olihandy/ENMT-ROBOCUP/CAD/T8x4 (P2) lead screw - 2.png

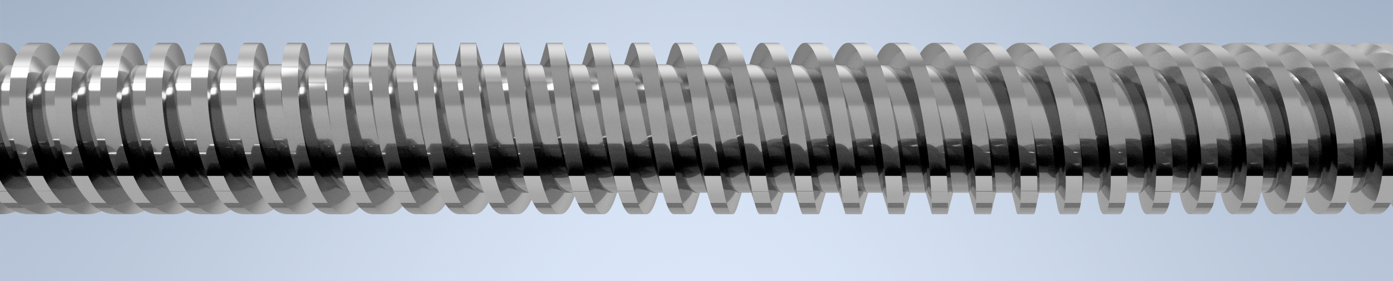
CAD/T8x4 (P2) lead screw - 2.png
