olihandy/ENMT-ROBOCUP/README.md

**TO DO**
1. Do cad
2. Build robot
3. Write report(s)
4. WIN ROBOCUP
