olihandy/ENMT-ROBOCUP/CAD/Robo_Assembly.SLDASM

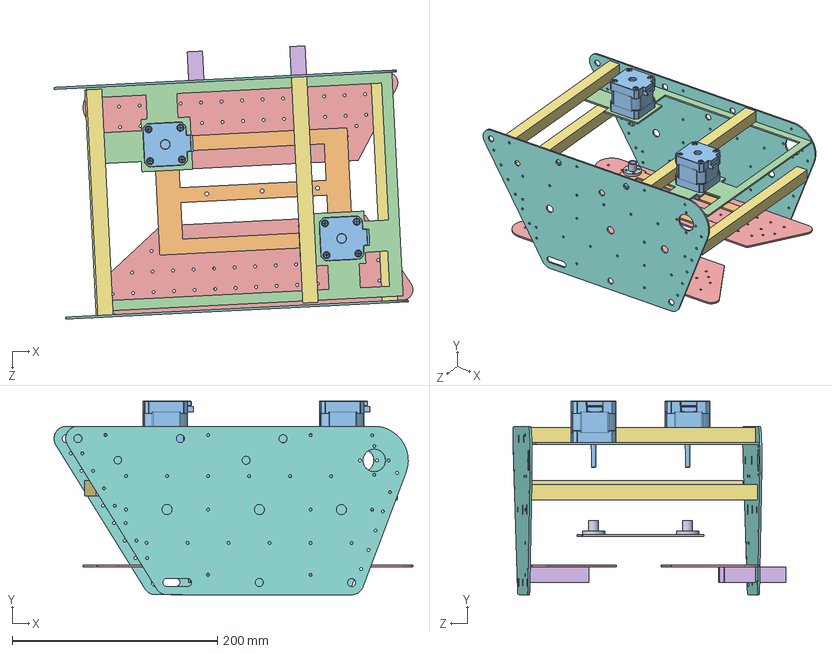
[picture p11: CAD file, 2024-07-29]
CAD/Robo_Assembly.SLDASM
349.6 x 188.7 x 266.1 mm
frame_side x 2
Open_Beam_300mm x 4
Open_Beam_30mm x 4
Frame_lower x 2
Frame_magnet mount
17HS4401 x 2
Frame_Electromagnet
brass piece x 2
