olihandy/ENMT-ROBOCUP/CAD/battery holder.SLDPRT

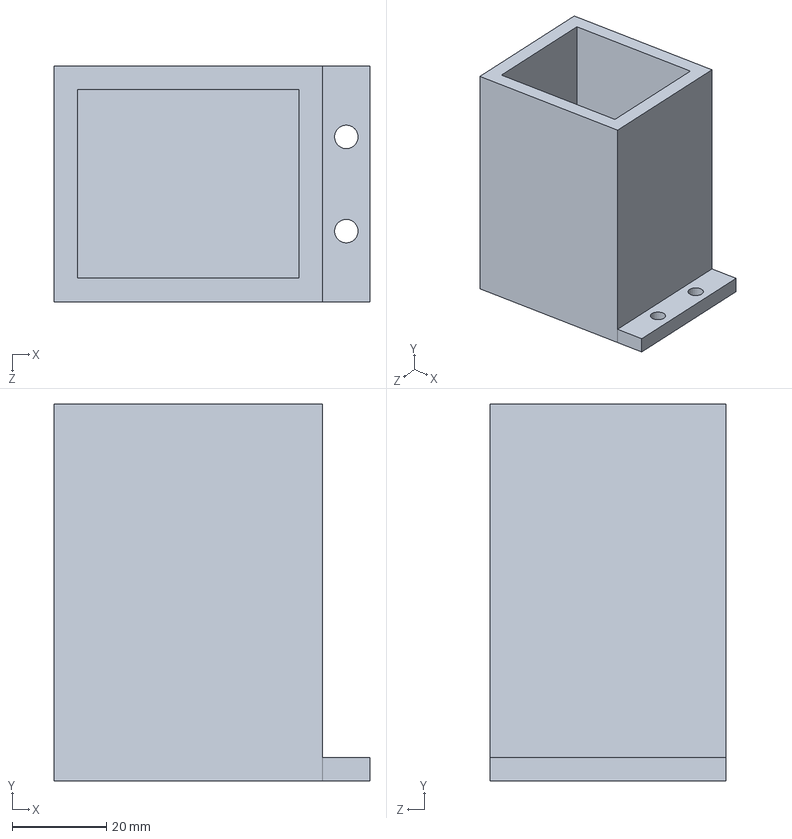
[picture p12: CAD file, 2024-09-09]
CAD/battery holder.SLDPRT
67.0 x 80.0 x 50.0 mm
