olihandy/ENMT-ROBOCUP/CAD/vl53l0x/pin_header.SLDPRT

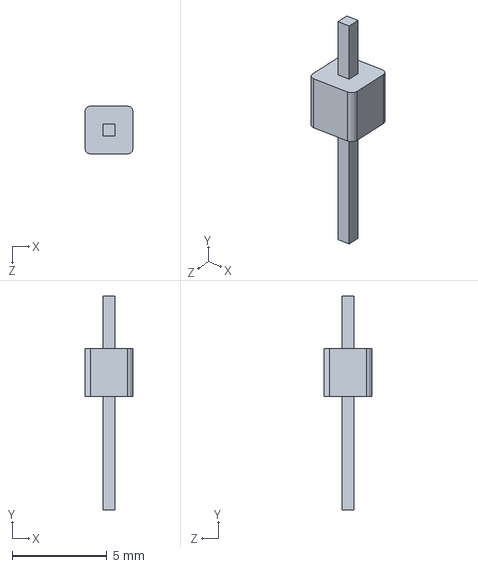
[picture p13: CAD file, 2024-09-09]
CAD/vl53l0x/pin_header.SLDPRT
2.54 x 11.3 x 2.54 mm
