olihandy/ENMT-ROBOCUP/CAD/motor driver.SLDPRT

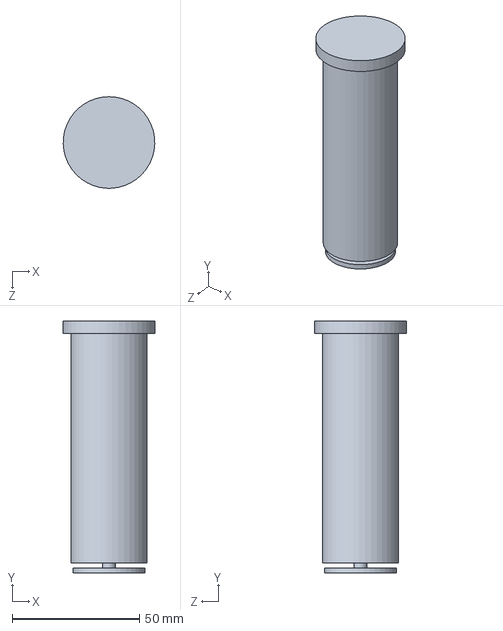
[picture p14: CAD file, 2024-09-09]
CAD/motor driver.SLDPRT
36.0 x 99.0 x 36.0 mm
