olihandy/ENMT-ROBOCUP/CAD/vl53l0x/GY-VL53L1XV2.SLDPRT

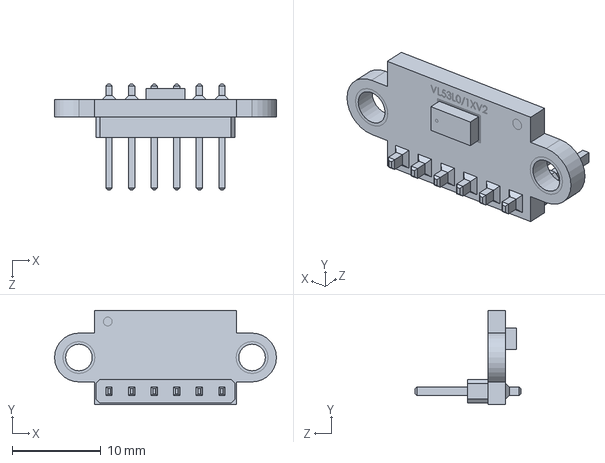
[picture p15: CAD file, 2024-09-09]
CAD/vl53l0x/GY-VL53L1XV2.SLDPRT
25.0 x 10.6 x 11.9 mm
