olihandy/ENMT-ROBOCUP/CAD/frame_side.SLDPRT

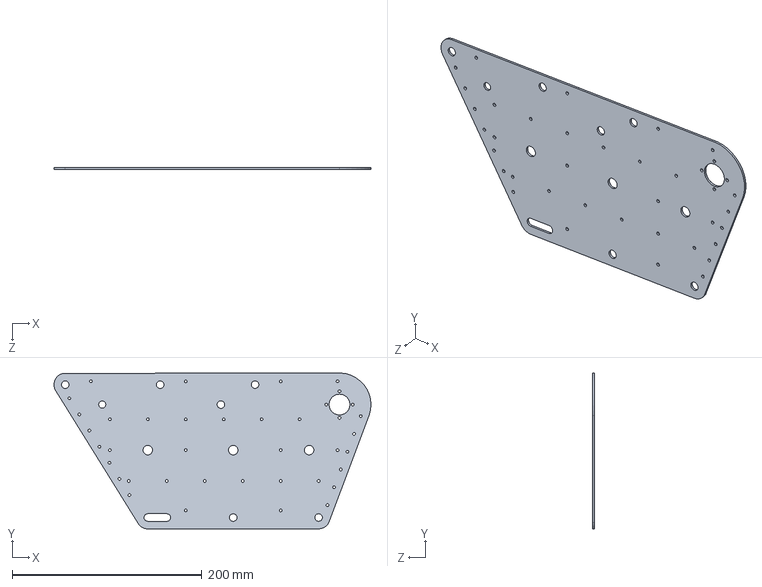
[picture p16: CAD file, 2024-09-09]
CAD/frame_side.SLDPRT
334.0 x 164.2 x 2.00 mm
