olihandy/ENMT-ROBOCUP/CAD/vl53l0x/vl53l0x_PCB.SLDPRT

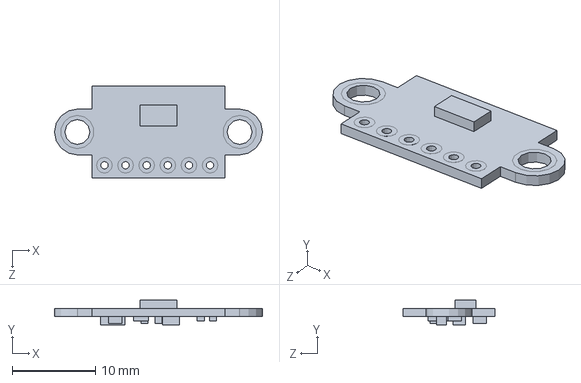
[picture p17: CAD file, 2024-09-09]
CAD/vl53l0x/vl53l0x_PCB.SLDPRT
25.0 x 3.00 x 11.0 mm
