olihandy/ENMT-ROBOCUP/CAD/Frame_Electromagnet.SLDPRT

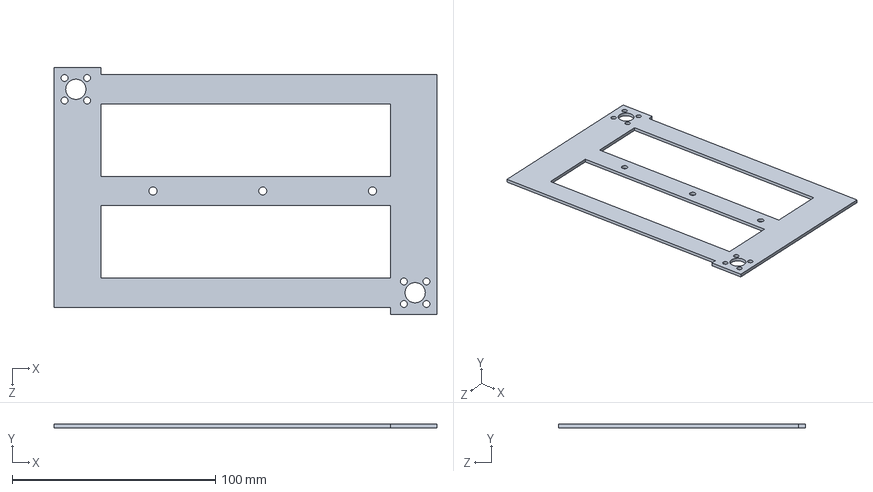
[picture p18: CAD file, 2024-09-09]
CAD/Frame_Electromagnet.SLDPRT
188.5 x 2.00 x 121.6 mm
