olihandy/ENMT-ROBOCUP/CAD/power supply.SLDPRT

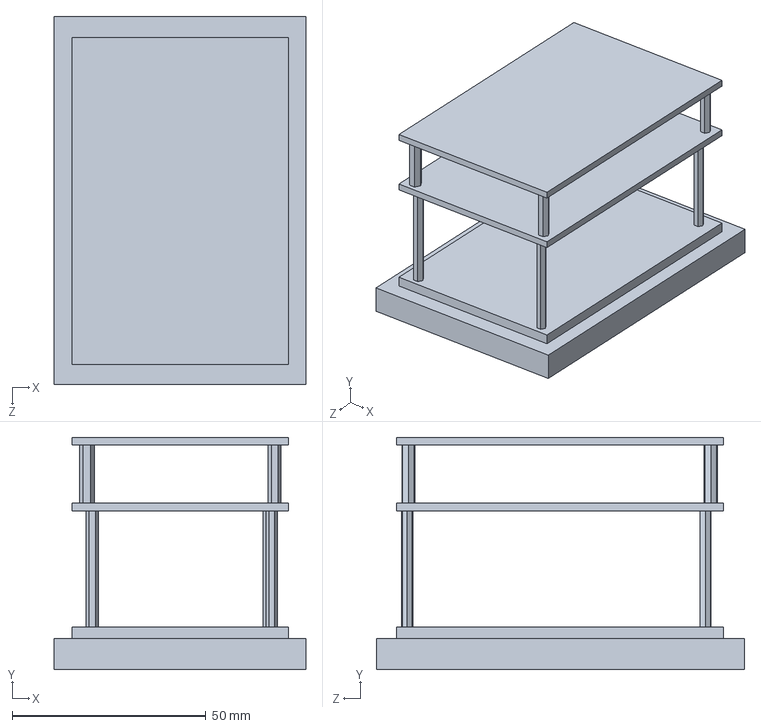
[picture p20: CAD file, 2024-09-09]
CAD/power supply.SLDPRT
65.0 x 60.0 x 95.0 mm
