olihandy/ENMT-ROBOCUP/CAD/vl53l0x/TOF_sensorholder.3MF

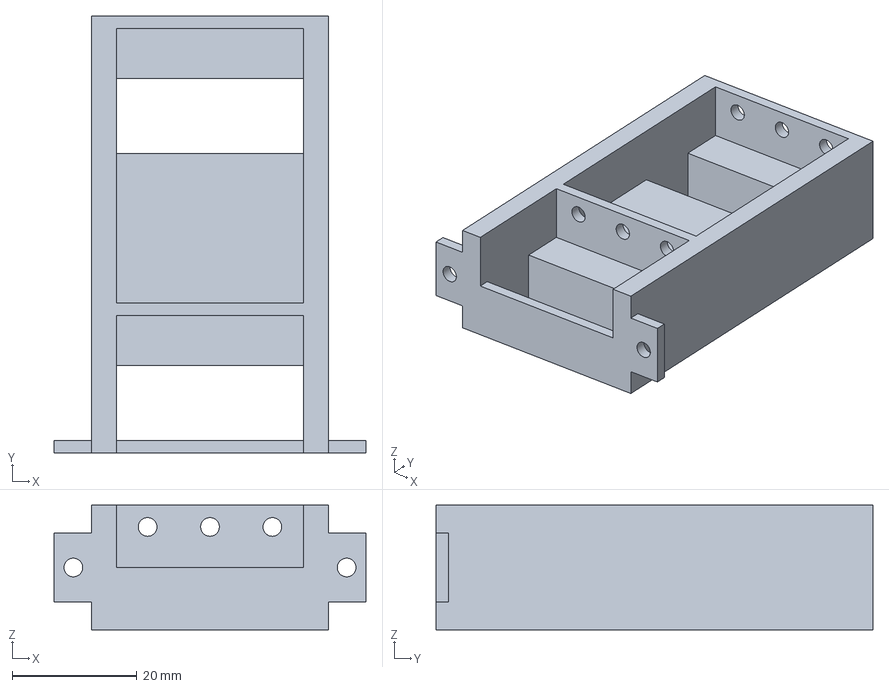
[picture p21: CAD file, 2024-09-09]
CAD/vl53l0x/TOF_sensorholder.3MF
50.0 x 70.0 x 20.0 mm
