olihandy/ENMT-ROBOCUP/CAD/track.SLDPRT

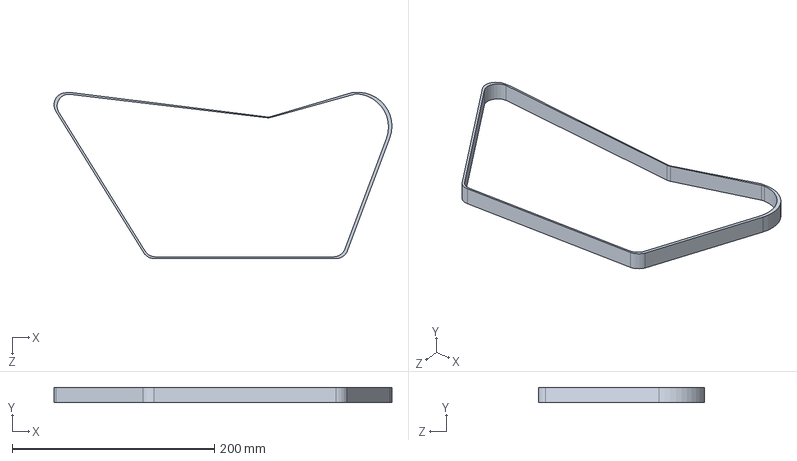
[picture p22: CAD file, 2024-09-09]
CAD/track.SLDPRT
334.0 x 15.0 x 164.2 mm
