olihandy/ENMT-ROBOCUP/CAD/1515 Aluminum Extrusion69420mm.SLDPRT

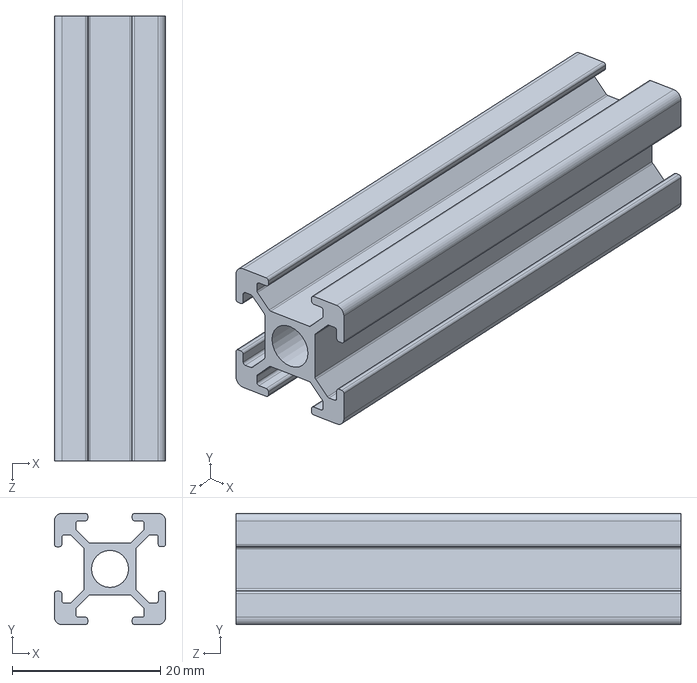
[picture p23: CAD file, 2024-09-09]
CAD/1515 Aluminum Extrusion69420mm.SLDPRT
15.0 x 15.0 x 60.0 mm
