olihandy/ENMT-ROBOCUP/CAD/wheel.SLDPRT

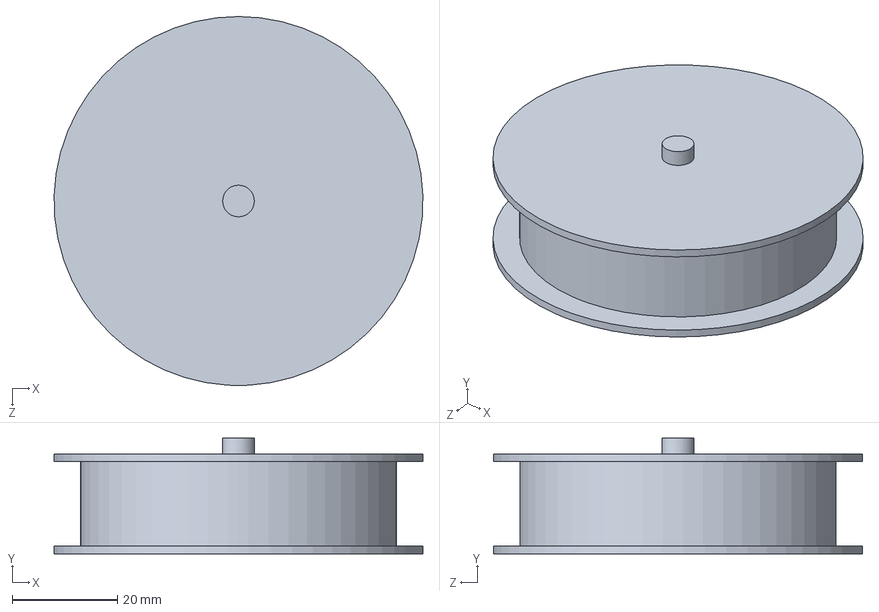
[picture p24: CAD file, 2024-09-09]
CAD/wheel.SLDPRT
70.0 x 22.0 x 70.0 mm
