olihandy/ENMT-ROBOCUP/CAD/Inductive level shift.SLDPRT

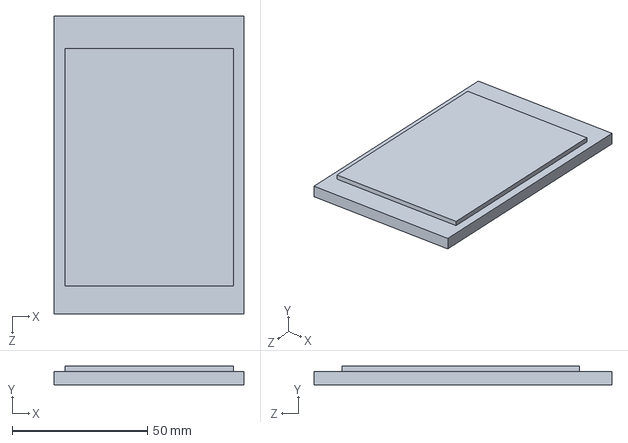
[picture p25: CAD file, 2024-09-09]
CAD/Inductive level shift.SLDPRT
70.0 x 7.00 x 110.0 mm
