olihandy/ENMT-ROBOCUP/CAD/1515 Aluminum Extrusion40mm.SLDPRT

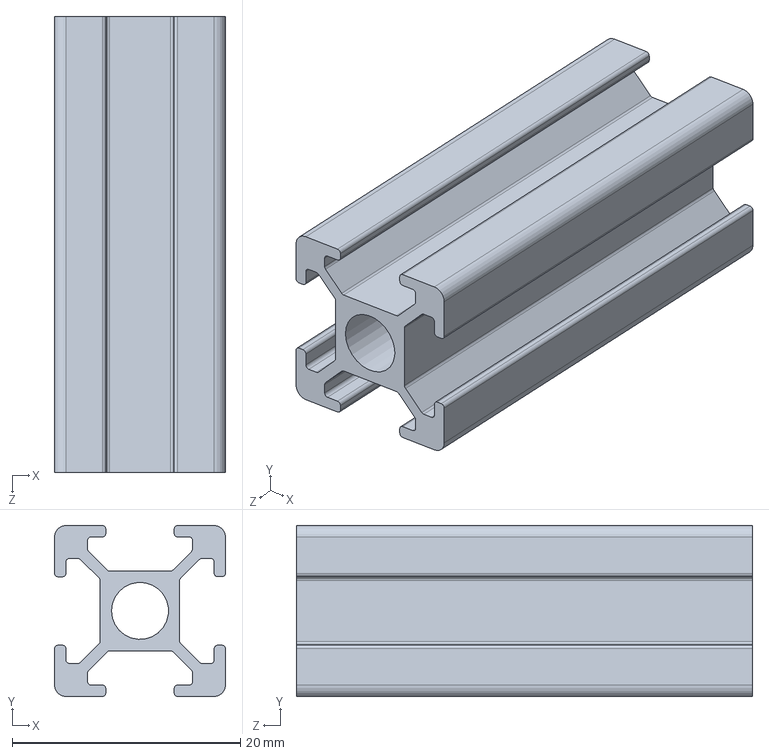
[picture p26: CAD file, 2024-09-09]
CAD/1515 Aluminum Extrusion40mm.SLDPRT
15.0 x 15.0 x 40.0 mm
