olihandy/ENMT-ROBOCUP/CAD/1515 Aluminum Extrusion220mm.SLDPRT

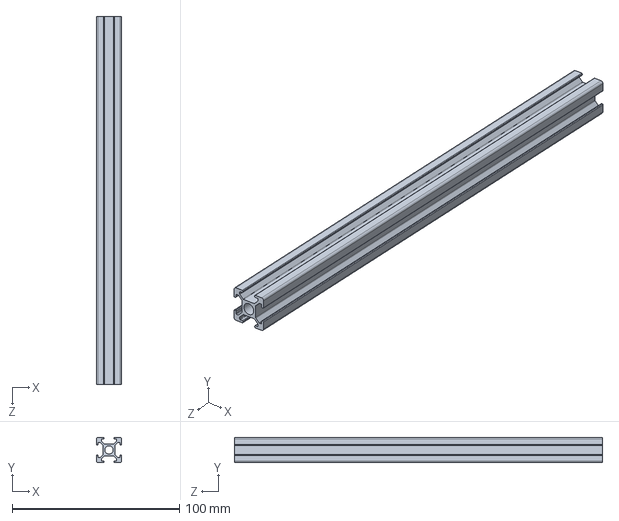
[picture p27: CAD file, 2024-09-09]
CAD/1515 Aluminum Extrusion220mm.SLDPRT
15.0 x 15.0 x 220.0 mm
