olihandy/ENMT-ROBOCUP/CAD/cpu.SLDPRT

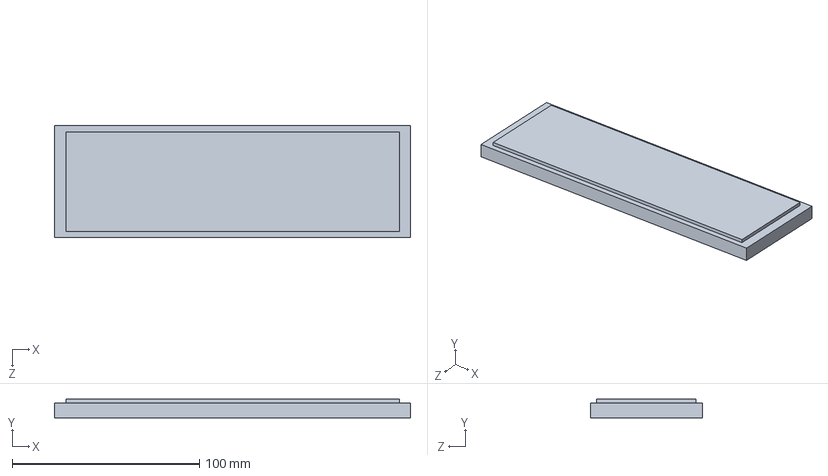
[picture p28: CAD file, 2024-09-09]
CAD/cpu.SLDPRT
190.0 x 10.0 x 60.0 mm
