olihandy/ENMT-ROBOCUP/CAD/upper sensor holder.SLDPRT

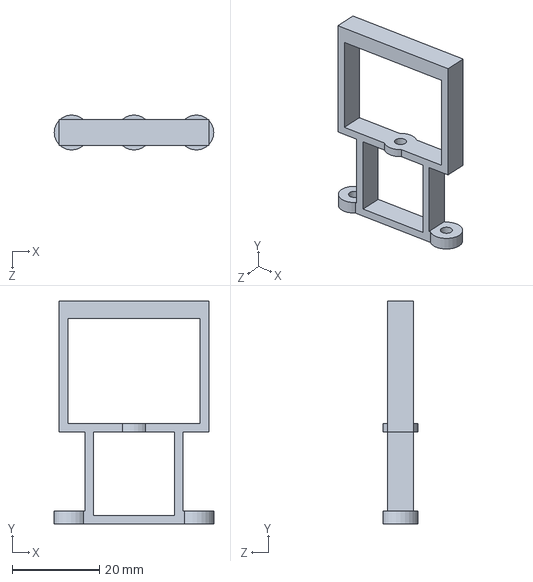
[picture p29: CAD file, 2024-09-05]
CAD/upper sensor holder.SLDPRT
36.5 x 51.0 x 8.00 mm
