olihandy/ENMT-ROBOCUP/CAD/Aluminium Profile 3030 30x30 mm.SLDPRT

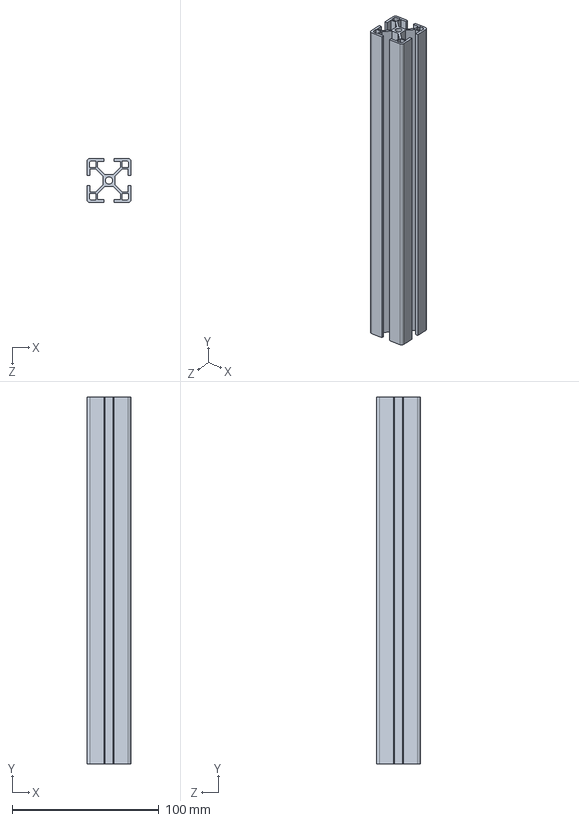
[picture p30: CAD file, 2024-09-05]
CAD/Aluminium Profile 3030 30x30 mm.SLDPRT
30.0 x 250.0 x 30.0 mm
