olihandy/ENMT-ROBOCUP/CAD/Open_Beam_300mm.SLDPRT

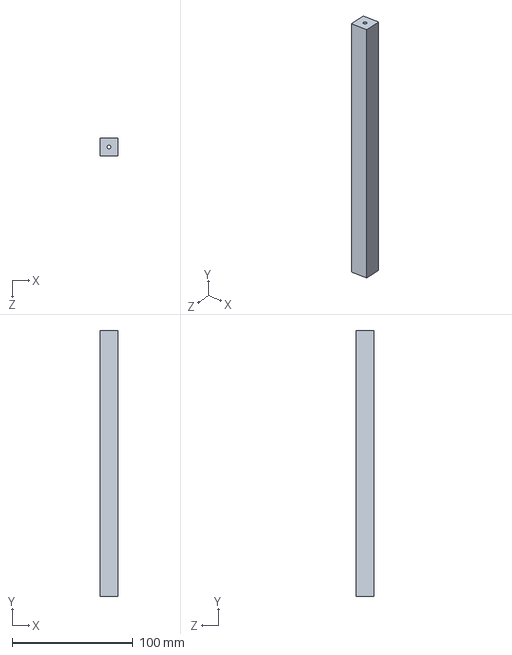
[picture p31: CAD file, 2024-09-03]
CAD/Open_Beam_300mm.SLDPRT
15.0 x 220.0 x 15.0 mm
