olihandy/ENMT-ROBOCUP/CAD/wheel cog rounded.SLDPRT

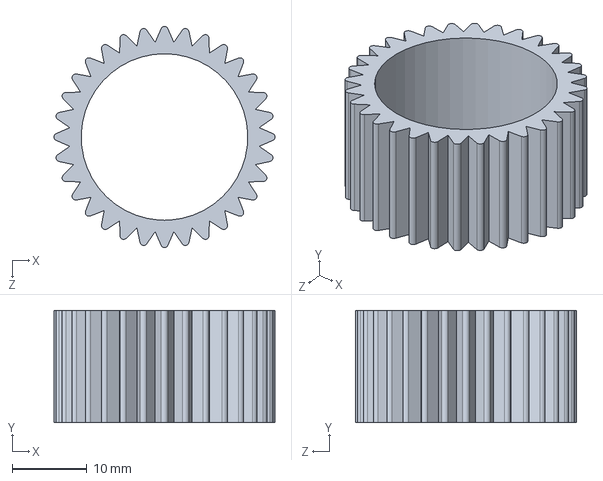
[picture p32: CAD file, 2024-09-03]
CAD/wheel cog rounded.SLDPRT
29.6 x 15.0 x 29.6 mm
