olihandy/ENMT-ROBOCUP/CAD/wheel cog final sharp.3MF

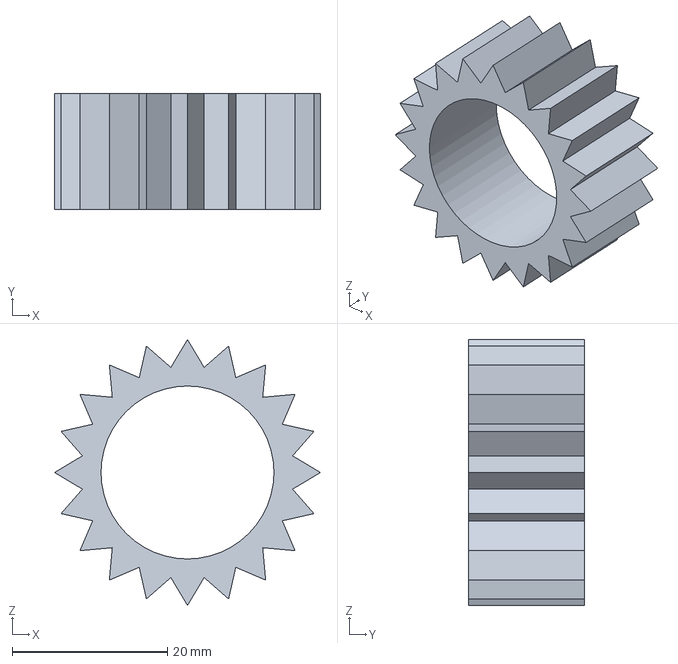
[picture p33: CAD file, 2024-09-03]
CAD/wheel cog final sharp.3MF
34.3 x 15.0 x 34.3 mm
