olihandy/ENMT-ROBOCUP/CAD/wheel cog final filleted.3MF

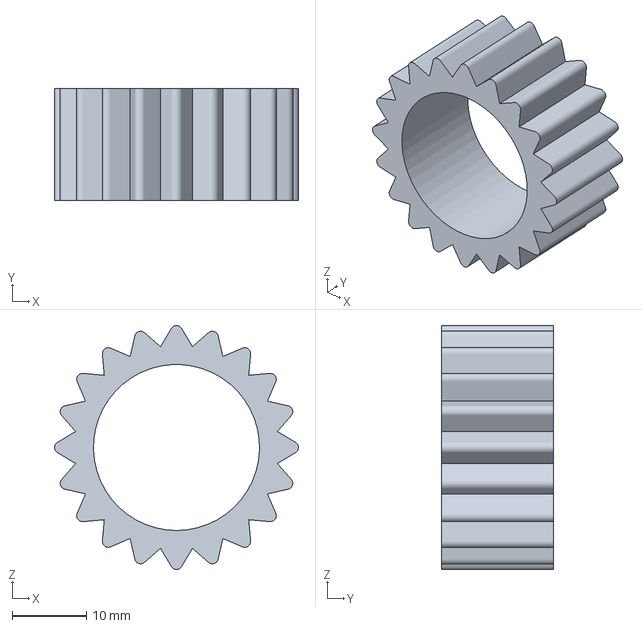
[picture p34: CAD file, 2024-09-03]
CAD/wheel cog final filleted.3MF
32.8 x 15.0 x 32.8 mm
