olihandy/ENMT-ROBOCUP/CAD/Frame_lower.SLDPRT

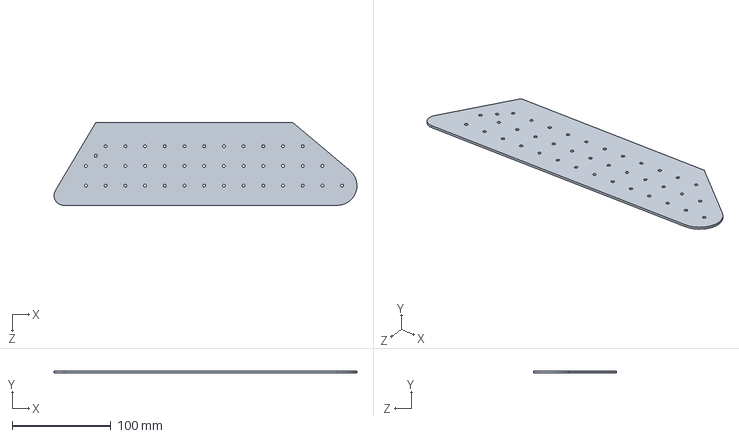
[picture p35: CAD file, 2024-09-03]
CAD/Frame_lower.SLDPRT
307.4 x 2.00 x 84.0 mm
