olihandy/ENMT-ROBOCUP/CAD/wheel cog2.3MF

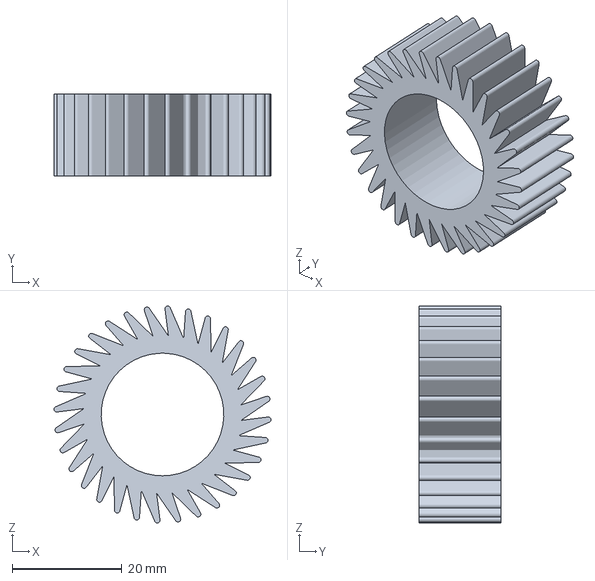
[picture p36: CAD file, 2024-09-03]
CAD/wheel cog2.3MF
39.5 x 15.0 x 39.5 mm
