olihandy/ENMT-ROBOCUP/CAD/wheel cog3 bigger.3MF

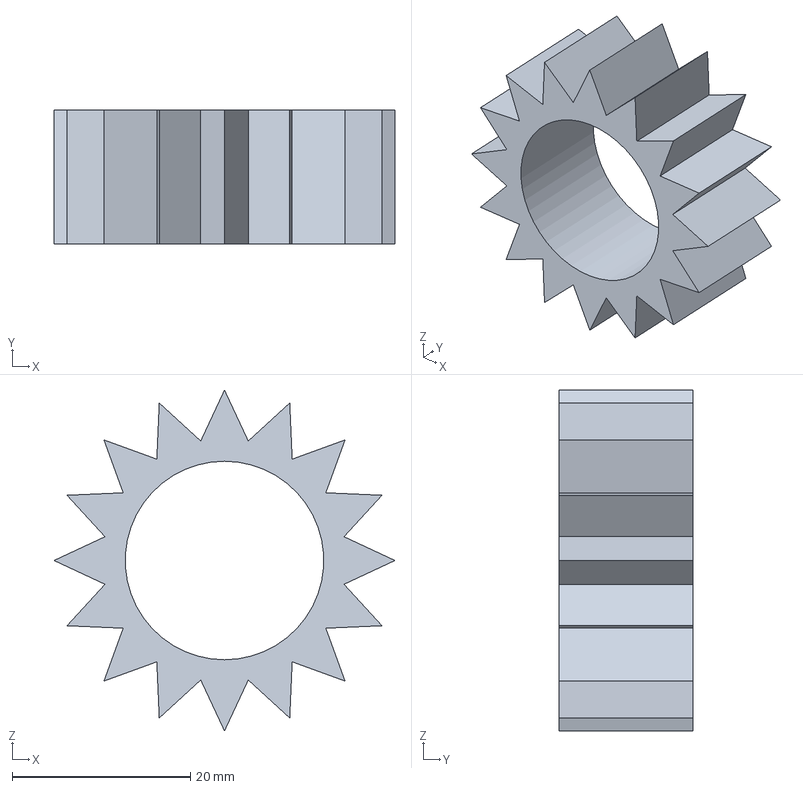
[picture p37: CAD file, 2024-09-03]
CAD/wheel cog3 bigger.3MF
38.3 x 15.0 x 38.3 mm
