olihandy/ENMT-ROBOCUP/CAD/bottom middle track wheel.3MF

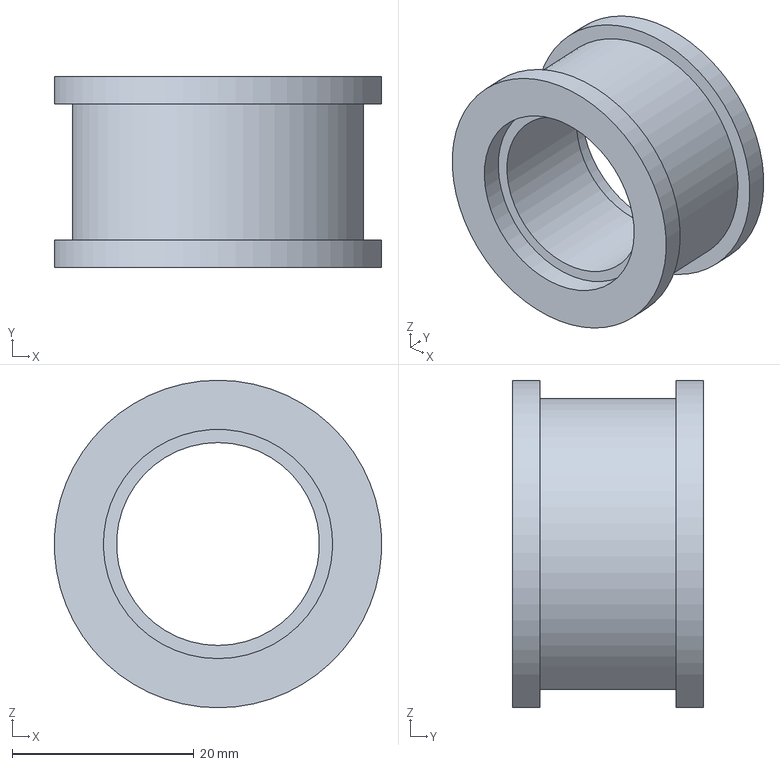
[picture p38: CAD file, 2024-09-03]
CAD/bottom middle track wheel.3MF
35.9 x 21.0 x 36.0 mm
