olihandy/ENMT-ROBOCUP/CAD/bearings.SLDPRT

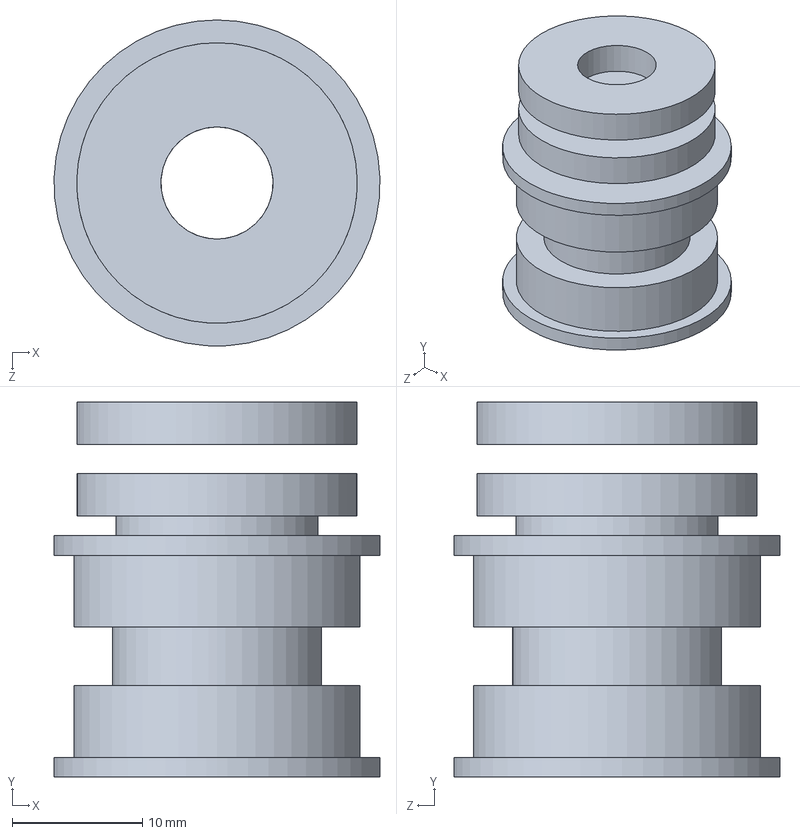
[picture p39: CAD file, 2024-09-03]
CAD/bearings.SLDPRT
25.0 x 28.8 x 25.0 mm
