olihandy/ENMT-ROBOCUP/CAD/brass piece.SLDPRT

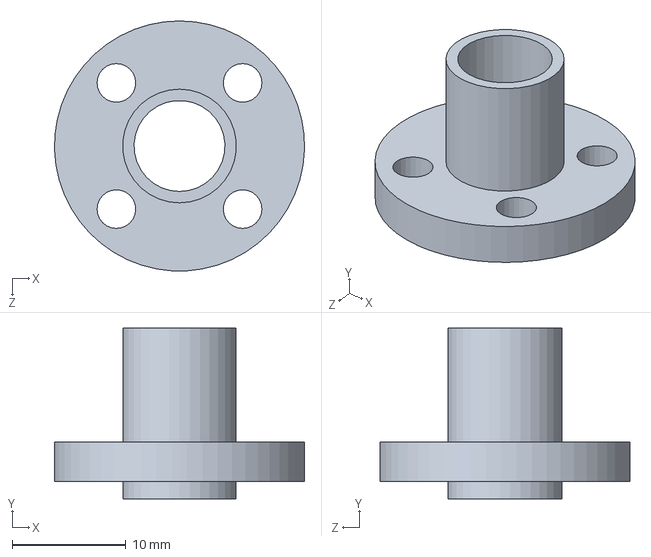
[picture p40: CAD file, 2024-09-03]
CAD/brass piece.SLDPRT
22.0 x 15.0 x 22.0 mm
