olihandy/ENMT-ROBOCUP/CAD/weight.SLDPRT

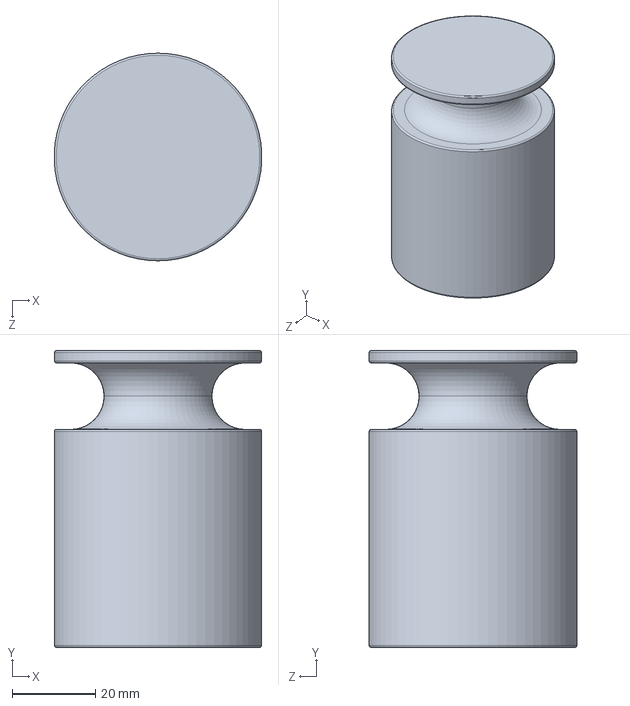
[picture p41: CAD file, 2024-09-03]
CAD/weight.SLDPRT
49.9 x 71.5 x 50.0 mm
