olihandy/ENMT-ROBOCUP/CAD/Frame_Middle_group31.DXF

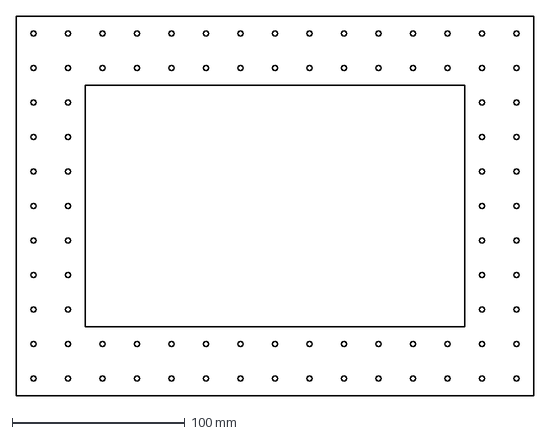
[picture p42: CAD file, 2024-08-20]
CAD/Frame_Middle_group31.DXF
300.0 x 220.0 mm
