olihandy/ENMT-ROBOCUP/CAD/Frame_Upper_Final_group31.DXF

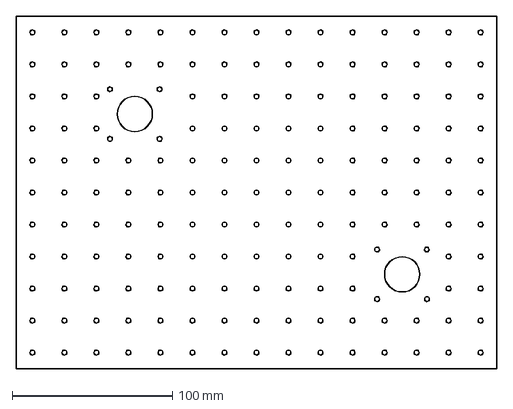
[picture p43: CAD file, 2024-08-20]
CAD/Frame_Upper_Final_group31.DXF
300.0 x 220.0 mm
