olihandy/ENMT-ROBOCUP/CAD/Frame_Electronics.SLDPRT

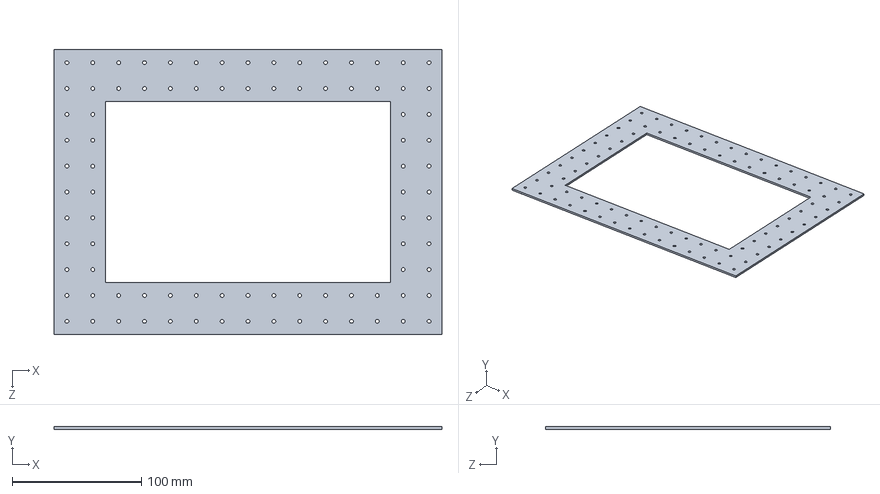
[picture p44: CAD file, 2024-08-20]
CAD/Frame_Electronics.SLDPRT
300.0 x 2.00 x 220.0 mm
