olihandy/ENMT-ROBOCUP/CAD/Frame_Electronics2.SLDPRT

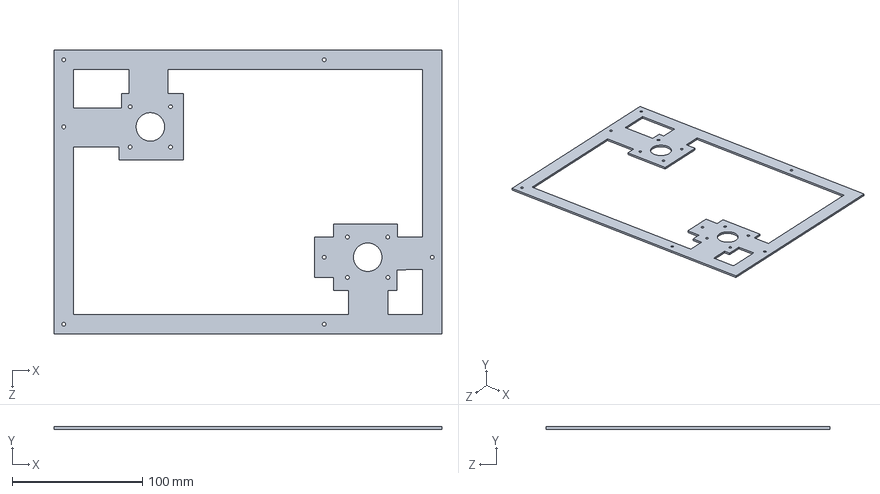
[picture p45: CAD file, 2024-08-20]
CAD/Frame_Electronics2.SLDPRT
298.0 x 2.00 x 218.0 mm
