olihandy/ENMT-ROBOCUP/CAD/Frame_Top.SLDPRT

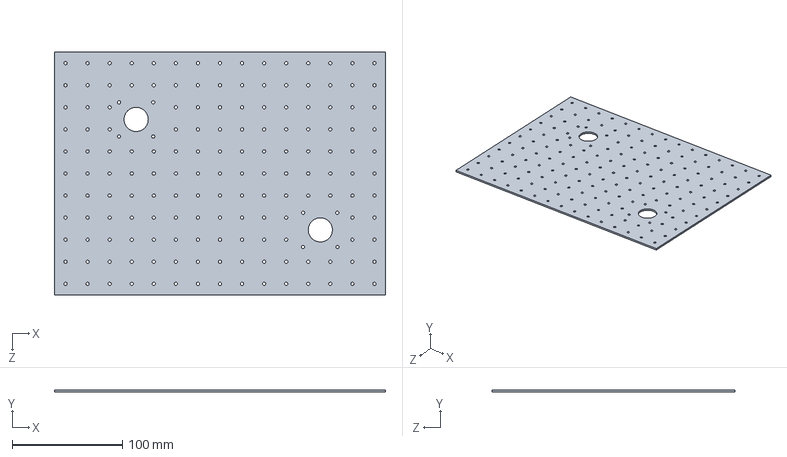
[picture p46: CAD file, 2024-08-20]
CAD/Frame_Top.SLDPRT
300.0 x 2.00 x 220.0 mm
