olihandy/ENMT-ROBOCUP/CAD/Open_Beam_30mm.SLDPRT

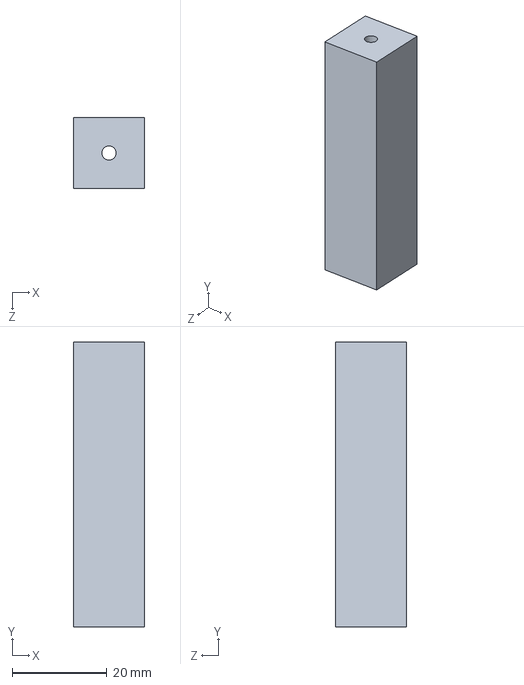
[picture p47: CAD file, 2024-08-20]
CAD/Open_Beam_30mm.SLDPRT
15.0 x 60.0 x 15.0 mm
