olihandy/ENMT-ROBOCUP/CAD/Frame_Electromagnet_group31.DXF

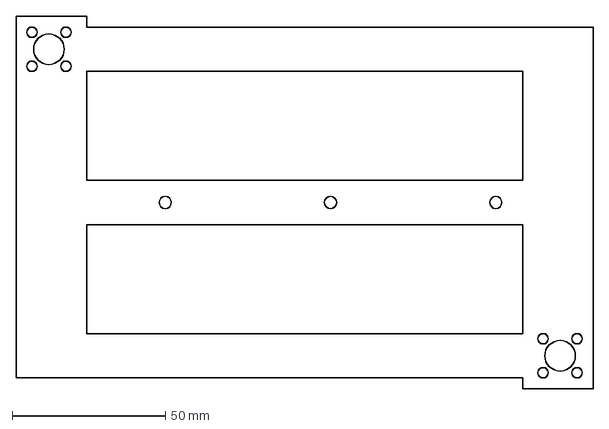
[picture p48: CAD file, 2024-08-20]
CAD/Frame_Electromagnet_group31.DXF
188.5 x 121.6 mm
