olihandy/ENMT-ROBOCUP/CAD/Frame_lower_print2x_group31.DXF

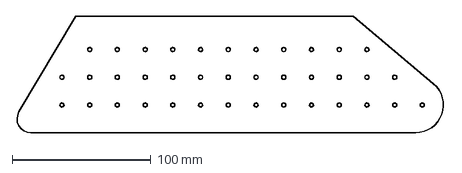
[picture p49: CAD file, 2024-08-20]
CAD/Frame_lower_print2x_group31.DXF
309.6 x 84.0 mm
