olihandy/ENMT-ROBOCUP/CAD/ECMagnet60Kg.SLDPRT

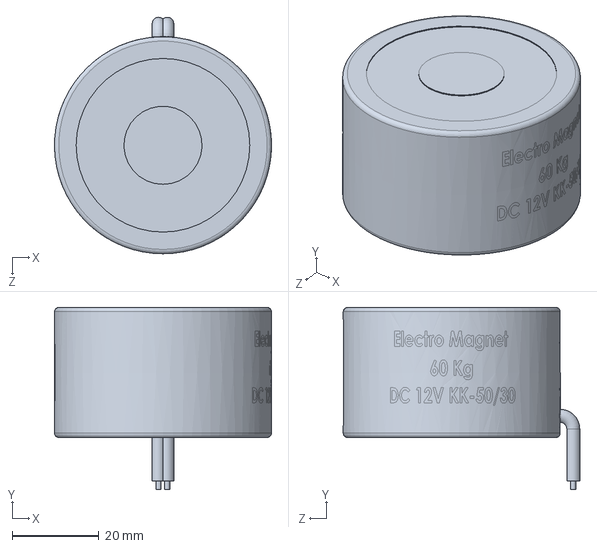
[picture p50: CAD file, 2024-08-06]
CAD/ECMagnet60Kg.SLDPRT
50.0 x 42.0 x 54.5 mm
