olihandy/ENMT-ROBOCUP/CAD/Frame_magnet mount.SLDPRT

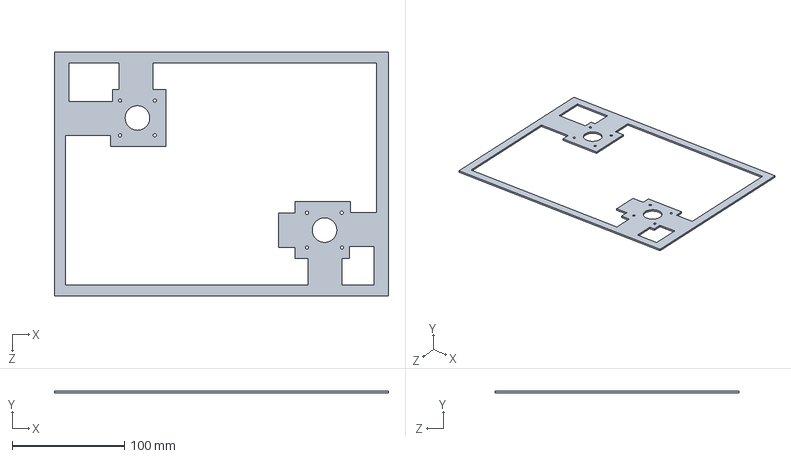
[picture p51: CAD file, 2024-07-29]
CAD/Frame_magnet mount.SLDPRT
298.0 x 2.00 x 218.0 mm
