olihandy/ENMT-ROBOCUP/CAD/17HS4401.SLDPRT

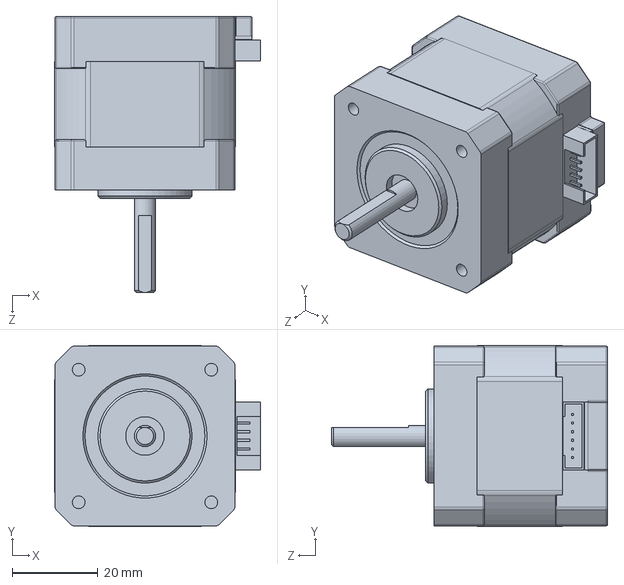
[picture p52: CAD file, 2024-07-29]
CAD/17HS4401.SLDPRT
48.2 x 42.3 x 64.5 mm
