olihandy/ENMT-ROBOCUP/CAD/sensor mount.STEP

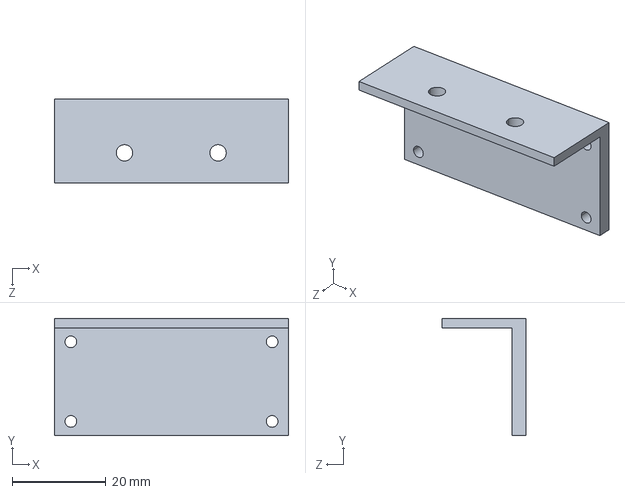
[picture p53: CAD file, 2024-07-29]
CAD/sensor mount.STEP
50.0 x 25.0 x 18.0 mm
