olihandy/ENMT-ROBOCUP/(list of files, cad)

Other CAD files:
CAD/vl53l0x/vl53l0x no headers.STEP
CAD/upper sensor holder2.3MF
CAD/1515 Aluminum Extrusion60mm.SLDPRT
CAD/wheel cog slightly rounded.3MF
CAD/wheel cog.SLDPRT
CAD/Frame_Electronics_proper.SLDPRT
CAD/Frame_middle.SLDPRT
CAD/Frame_magnets'.SLDPRT
CAD/Frame_Electromagnet.DXF
CAD/Frame_Electromagnet.SLDDRW
CAD/Frame_Electronics.3MF
CAD/Frame_Electronics.DXF
CAD/Frame_Top.SLDDRW
CAD/Frame_lower.DXF
CAD/Frame_lower.SLDDRW
CAD/ISO Metric Trapezoidal Screw.SLDPRT
CAD/T8x4 (P2) lead screw.ipt
CAD/battery holder.3MF
CAD/battery holder.SLDDRW
CAD/final screw 8mm.SLDPRT
CAD/final screw 8mmsld.SLDPRT
CAD/screw.SLDPRT
CAD/sensor mount.3mf
CAD/sensor mount.SLDPRT
CAD/upper sensor holder.3MF
CAD/upper sensor holder.SLDDRW
CAD/vl53l0x/vl53l0x.SLDASM
