olihandy/ENMT-ROBOCUP/ourcode/Robocup Code/Combined_Code/ReturningHome.h

// ReturningHome.h

#ifndef RETURNINGHOME_H
#define RETURNINGHOME_Hc:\Users\aos30\OneDrive - University of Canterbury\University\2024\ENMT ENME 301\Robocup\ENMT-ROBOCUP\ourcode\Robocup Code\Combined_Code\ReturningHome.cpp

#include "Actuators.h"
#include "IMU.h"
#include "Sensors.h"

extern void return_home(void);

#endif //RETURNINGHOME_H
