olihandy/ENMT-ROBOCUP/ourcode/Robocup Code/Combined_Code/WeightCollection.h

// WeightCollection.h

#ifndef WEIGHTCOLLECTION_H
#define WEIGHTCOLLECTION_H 

#include "Sensors.h"
#include "Actuators.h"
#include <stdio.h>

extern int NumWeightsCollected;

void CollectWeight_1(void);
void CollectWeight_2(void);
void CollectWeight_3(void);


#endif //WEIGHTCOLLECTION_H
