olihandy/ENMT-ROBOCUP/(commit log)

2024-07-15 Add files via upload
    initial commit
    [frame_side.SLDPRT]
2024-07-15 cad prototyping
    [Frame_lower.SLDPRT, Frame_middle.SLDPRT, Open_Beam_300mm.SLDPRT, Open_Beam_30mm.SLDPRT, Robo_Assembly.SLDASM, frame_side.SLDPRT]
2024-07-18 Create Newfile for IMU
2024-07-18 IMU into IMU folder
2024-07-18 adding cad files and merging
2024-07-18 updated cad
    [Frame_magnet mount.SLDPRT, Frame_middle.SLDPRT, Open_Beam_30mm.SLDPRT, Robo_Assembly.SLDASM, frame_side.SLDPRT]
2024-07-22 updated stepper code
    [Frame_magnet mount.SLDPRT, Frame_magnets'.SLDPRT]
2024-07-24 Update and rename motor_go.ino to Sensor_motor_test.ino
2024-07-29 Add files via upload
    Sensor Mounts
    [sensor mount.3mf, sensor mount.SLDPRT, sensor mount.STEP]
2024-07-29 added and updated solidworks files
    [17HS4401.SLDPRT, Frame_Electromagnet.SLDPRT, Frame_Electronics.SLDPRT, Frame_Electronics_proper.SLDPRT, Frame_lower.SLDPRT, Frame_magnet mount.SLDPRT, Frame_middle.SLDPRT, ISO Metric Trapezoidal Screw.SLDPRT]
2024-07-30 Delete ourcode/Combined_Code_Robocup/motor_go directory
    Identical program in folder above
2024-08-01 stepper motor code
2024-08-05 Add files via upload
    Basic IMU sensor code
2024-08-06 updated code
    [ECMagnet60Kg.SLDPRT, Frame_Electromagnet.DXF, Frame_Electronics.3MF, Frame_Electronics.DXF, Frame_Electronics.SLDPRT, Frame_Electronics_proper.SLDPRT, Frame_lower.DXF, Frame_lower.SLDPRT]
2024-09-03 more cad
    [Frame_Electromagnet.SLDPRT, Frame_lower.SLDPRT, Open_Beam_300mm.SLDPRT, bearings.SLDPRT, bottom middle track wheel.3MF, brass piece.SLDPRT, frame_side.SLDPRT, upper sensor holder.3MF]
2024-09-05 redoing deleted cad
    [1515 Aluminum Extrusion220mm.SLDPRT, 1515 Aluminum Extrusion60mm.SLDPRT, 1515 Aluminum Extrusion69420mm.SLDPRT, Aluminium Profile 3030 30x30 mm.SLDPRT, T8x4 (P2) lead screw.ipt, final screw 8mm.SLDPRT, final screw 8mmsld.SLDPRT, screw.SLDPRT]
2024-09-09 added drawings -oha49
    [Frame_Top.SLDDRW, Frame_lower.SLDDRW, battery holder.SLDDRW, upper sensor holder.SLDDRW]
2024-09-18 added in print readings
2024-09-18 added h file for the print readings section, maybe rename to sensors
2024-09-18 added actuators and sensors and changed names
2024-09-18 Got functionality of combined_code using actuators and sensors
2024-09-18 Made it work better, definitely need some kind of scheduler, the sensor messages take ages with more motor commands
2024-09-24 added sensor buffering and added to the FSM
2024-09-26 sensor buffering works now
2024-10-03 changed electromagnet pins and made collection slower to help with stepper motor error
    [Actuators.cpp, Actuators.h, Navigation.cpp, Navigation.h]
2024-10-03 IMU stuff
2024-10-04 IMu changes
2024-10-04 Added IMU angle stuff
2024-10-05 Added non blocking motor stuff, now it broken
    [Actuators.cpp, Actuators.h, Combined_Code.ino, Navigation.cpp, Navigation.h, SensorBuffering.cpp, SensorBuffering.h, Sensors.cpp]
